Omar-404-BlackOps/AquaTrident/BOM.md

# AquaTrident – bill of materials

<!-- Generated by Half Life from project cmuvihf2q001z01pyso7ifghx. Edits here are overwritten on the next sync. -->
<!-- Generated: 2026-10-12T00:16:21.792Z -->

> [!NOTE]
> This parts list is mirrored from [Half Life](https://halflife.hackclub.com). Editing it here will not change the platform's copy, and the next sync overwrites this file.

| Week | Tier | Parts funding |
| --- | --- | --- |
| Week 1 | Tier 3 | $100.00 |

| Part | What it's for | Qty | Unit | Total | Vendor |
| --- | --- | --- | --- | --- | --- |
| [Arduino Uno Rev3](https://makerselectronics.com/product/arduino-uno-rev3/) | The main brain that controls the system. | 1 | $6.46 | $6.46 | [Makers Electronics](https://makerselectronics.com/product/arduino-uno-rev3/) |
| [20x4 LCD I2C Module](https://www.amazon.eg/-/en/ZHITING-Serial-Module-Arduino-Mega2560/dp/B0859YY2NZ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) | Displaying real-time readings for monitoring. | 1 | $4.25 | $4.25 | [Amazon.eg](https://www.amazon.eg/-/en/ZHITING-Serial-Module-Arduino-Mega2560/dp/B0859YY2NZ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) |
| [pH Sensor](https://makerselectronics.com/product/analog-ph-meter-sensor/) | An Analog sensor that measures the acidity/alkalinity and transmits the readings to the main processor. | 1 | $19.95 | $19.95 | [Makers Electronics](https://makerselectronics.com/product/analog-ph-meter-sensor/) |
| [Relay Module (1 Channel) Active Low Trigger 12V](https://makerselectronics.com/product/relay-module-1-channel-active-low-trigger-12v-hw-307/) | Control high voltage devices (pump, valve, and aerator), depending on the Arduino signals. | 3 | $0.76 | $2.28 | [Makers Electronics](https://makerselectronics.com/product/relay-module-1-channel-active-low-trigger-12v-hw-307/) |
| [Turbidity Sensor with Board Module](https://makerselectronics.com/product/tds-sensor-with-board-module-v1-0/) | An Analog sensor that measures water clarity by detecting suspended particles indicating water contamination levels. | 1 | $8.55 | $8.55 | [Makers Electronics](https://makerselectronics.com/product/tds-sensor-with-board-module-v1-0/) |
| [Analog TDS Sensor Module](https://makerselectronics.com/product/tds-sensor-with-board-module-v1-0/) | An Analog sensor that measures total dissolved solids (ppm) indicating water purity and salinity levels. | 1 | $8.55 | $8.55 | [Makers Electronics](https://makerselectronics.com/product/tds-sensor-with-board-module-v1-0/) |
| [12V DC Water Pump](https://makerselectronics.com/product/qr30e-ultra-quiet-brushless-dc-water-pump-12vdc-4-8w-300l-h-ip68/) | Pumps clean water into the system. | 1 | $4.75 | $4.75 | [Makers Electronics](https://makerselectronics.com/product/qr30e-ultra-quiet-brushless-dc-water-pump-12vdc-4-8w-300l-h-ip68/) |
| [Water Solenoid Valve 12V](https://makerselectronics.com/product/pressure-plastic-electric-water-sol/) | Drains contaminated water out of the system. | 1 | $3.32 | $3.32 | [Makers Electronics](https://makerselectronics.com/product/pressure-plastic-electric-water-sol/) |
| [Aerator Oxygen Pump](https://www.amazon.eg/-/en/VAYINATO-Electricals-Silent-Aerator-Oxygen/dp/B09GG6PHGM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) | Feeds the water with oxygen as well as stabilizing pH levels. | 1 | $9.31 | $9.31 | [Amazon.eg](https://www.amazon.eg/-/en/VAYINATO-Electricals-Silent-Aerator-Oxygen/dp/B09GG6PHGM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) |
| **Parts subtotal** | — | — | — | **$67.42** | — |
| **Tax & shipping** | — | — | — | **$0.00** | — |
| **Total** | — | — | — | **$67.42** | — |

$32.58 left of the tier's funding.
