Omar-404-BlackOps/AquaTrident/BOM.csv

Name | Purpose | Quantity | Total Cost (USD) | Link | Distributor
Clear Hose Tube Pipe | Enables transferring water into/out of the system. |  | 0.32 | https://makerselectronics.com/product/clear-hose-tube-pipe-6mmx4mm-1-meter/ | Makers Electronics
Arduino Uno Rev3 | The main brain that controls the system. | 1 | 28.48 | https://makerselectronics.com/product/arduino-uno-rev3-designed-and-assembled-in-italy/ | Makers Electronics
Solder-able Breadboard | Holds connections | 1 | 3.00 | https://makerselectronics.com/product/osepp-solder-able-breadboard/ | Makers Electronics
Jumper wires | Connecting components through breadboard. | 120 | 2.50 | https://www.amazon.eg/-/en/ELEGOO-Multicolored-Breadboard-Compatible-Projects/dp/B01EV70C78 | Amazon.eg
Sponge Filter Pads | Curing and filtering drained out water so it can be reused. | 1 | 20.87 | https://www.amazon.eg/-/en/Bukela-Aquarium-Reusable-Filters-Filtering/dp/B0FBRVPPZF | Amazon.eg
Activated Charcoal Carbon Pellets bag | Curing and filtering drained out water so it can be reused. | 1 | 20.89 | https://www.amazon.eg/-/en/gp/product/B07KPQ4RPY/ref=ewc_pr_img_1?smid=A29EIP580Q1AVP&psc=1 | Amazon.eg
Power Supply 12V 3A | Provides the system with adequate power (Current & Voltage). | 1 | 4.00 | https://makerselectronics.com/product/ab36w-12-power-supply-12v-3a/ | Makers Electronics
Relay Module 12V | Control high voltage devices (pump, valve, and aerator), depending on the Arduino signals. | 3 | 2.28 | https://makerselectronics.com/product/relay-module-1-channel-active-low-trigger-12v-hw-307/ | Makers Electronics
Aerator Oxygen Pump | Feeds the water with oxygen as well as stabilizing pH levels. | 1 | 9.31 | https://www.amazon.eg/-/en/VAYINATO-Electricals-Silent-Aerator-Oxygen/dp/B09GG6PHGM | Amazon.eg
Water Solenoid Valve 12V | Drains contaminated water out of the system. | 1 | 6.80 | https://www.amazon.eg/-/en/gp/product/B0DD7WXYCD/ref=ewc_pr_img_2?smid=A2DMKAT7ZKLGQN&psc=1 | Amazon.eg
12V DC Water Pump | Pumps clean water into the system. | 1 | 4.75 | https://makerselectronics.com/product/qr30e-ultra-quiet-brushless-dc-water-pump-12vdc-4-8w-300l-h-ip68/ | Makers Electronics
20x4 LCD I2C Module | Displaying real-time readings for monitoring. | 1 | 4.25 | https://www.amazon.eg/-/en/ZHITING-Serial-Module-Arduino-Mega2560/dp/B0859YY2NZ | Amazon.eg
Turbidity Sensor with Board Module | An Analog sensor that measures water clarity by detecting suspended particles indicating water contamination levels. | 1 | 8.55 | https://makerselectronics.com/product/tds-sensor-with-board-module-v1-0/ | Makers Electronics
Analog TDS Sensor Module | An Analog sensor that measures total dissolved solids (ppm) indicating water purity and salinity levels. | 1 | 8.55 | https://makerselectronics.com/product/tds-sensor-with-board-module-v1-0/ | Makers Electronics
pH Sensor | An Analog sensor that measures the acidity/alkalinity and transmits the readings to the main processor. | 1 | 19.95 | https://makerselectronics.com/product/analog-ph-meter-sensor/ | Makers Electronics
~10L Fish Tank | The main enclosure and body, and simulating an aquatic environment. | 1 | 75.00 | https://www.amazon.eg/-/en/gp/product/B091DXLBPS/ref=ewc_pr_img_1?smid=A17KADTUM4QTZ9&psc=1 | Amazon.eg
