Omar-404-BlackOps/AquaTrident/JOURNAL.md

# AquaTrident – devlog

<!-- Generated by Half Life from project cmuvihf2q001z01pyso7ifghx. Edits here are overwritten on the next sync. -->
<!-- Generated: 2026-10-12T00:46:14.590Z -->

> [!NOTE]
> This devlog is mirrored from [Half Life](https://halflife.hackclub.com). Editing it here will not change the platform's copy, and the next sync overwrites this file.

> AquaTrident, as its name suggests, is an aquaculture control/feedback system that monitors vital aquatic parameters, such as pH, Turbidity and TDS, designed for monitoring and regulating the environment conditions to be adequate for marine life specific types, in addition to providing real life data of the controlled system.

| Week | Tier | Hours logged | Entries |
| --- | --- | --- | --- |
| Week 1 | Tier 3 | 18.5h | 5 |

## Contents

1. [2026-10-11 – Project planning:](#2026-10-11-project-planning)
2. [2026-10-11 – Schematic Designing:](#2026-10-11-schematic-designing)
3. [2026-10-11 – I started working on editing the code for this session, and here is a mini part of the code:](#2026-10-11-i-started-working-on-editing-the-code-for-this-se)
4. [2026-10-11 – In this session I worked with a mate on the code, we faced a lot of errors and dysfunctions in the system, so we had a lot test trials to solve dysfunctions in order to make this system work out.](#2026-10-11-in-this-session-i-worked-with-a-mate-on-the-code-)
5. [2026-10-11 – pH Calibration](#2026-10-11-ph-calibration)

## Design

### 2026-10-11 – Project planning:

**1.5h**

Project planning:
Intro:
In this session I have planned the project, and for me I think that project planning can be divided into sections such as:

1.Main Plan

2.Materials Plan

3.Wiring Layout

4.Construction plan

so let's start with what I did for each part.

Main Plan:
Here is where I planned the above sections, and planned what I really want to do, so I decided to build an Aquaculure montoring system (Since I live in a coastal area), chose these 3 parameters: (pH, Turbidity and TDS), that I'll make a water recycling system .. that's only based on the desire of learning by making...

Then I moved to the next step so let us move to it as well.

Materials Plan:
Here is where I decided the materials, components, and electronoics that I'll work with, so I have done that by opening multiple local suppliers websites beside Amazon, as you can see here:




Then I started comparing items based on quality while having a wide eye on the price, so I had to ensure that I am picking a high quality item while maitaining the price is afforable, and I'll discuss why I chose every item in an upcoming journal.

Wiring Layout:
Here I planned all the wiring connections between each component and the other by designing a schematic diagram using "KiCad".

Construction plan:
Here is where I planned how I will construct and make every thing work out.

This isn't detailed since I am going to dive in details in the upcoming journals.
END OF THE JOURNAL...

### 2026-10-11 – Schematic Designing:

**6h**

Schematic Designing:
I worked on designed the schematic on KiCad, I faced a lot of obstacles since it was kind of my first time to design a schematic in my life, so I recommend watching tutorials before you start your own schematic. And here is how my first designing session ended:


Where I placed the main Arduino board, searched for the relay module and used the one in the image, placed 3 relay modules, and finally I placed 3 2x Pins to represent the actuators VCC & GND.

and then when I wanted to connect theses actuators to the relays, I got confused because of the relays, since their pins are labeled in number instead of actual labels (e.g. COM, IN, VCC, GND, NO, NC), so these connections need some research and understanding, which I am willing to do on the next working session.

Completing the Schematic:
I worked on solving the relay confusion and finally reached the solution and even understood the mechanism of how relays work, so here is how my schematic looked like after that designing session:


So here is how it went:

Relay modules’ A2 pins were connected to Arduino’s digital pins (D5, D6, D7) along with connecting A1 pins to Arduino’s 5V and connecting all NO pins to actuators positive pins enabling control.

All relay’s COM (common) pins were connected to the 12V power supply and finally a common ground was established across all the circuit ensuring a stable and safe circuit.

I finally Finished the Schematic (:
I worked on completing the schematic, and polishing it until it reached this pretty design:



Placed 2x pins to represent the sensors wires.
Sensors’ signal pins were connected to Arduino’s analog pins (A0, A1, A2) enabling real time monitoring, sensors VCC pins were connected to Arduino’s 5V providing safe operating voltage, and LCD were attached to the Arduino through I2C enabling data logging.

You might take a closer look here (:



and when I say polishing I mean solved the errors, organized all the wire connections to look that pretty, established the GND & Power flags and blocked (X) all the pins that I didn't need.

Although connections wasn't easy and costed me a lot of time learning and wiring them, it weren't the final obstcale in the design, just as any IDE has a checking tool, KiCad has the ERC tool, so when I used this tool, more than 10 errors popped up across the design, however I debugged them untill I reached this:





### 2026-10-11 – I started working on editing the code for this session, and here is a mini part of the code:

**3h**

I started working on editing the code for this session, and here is a mini part of the code:



I installed needed libraries, and defined some pins for the sensors and actuators, in addtion to defining the relays to normally closed (LOW as a standard), since we don't want the actuators to start working with start of the system, insteed we need the actuators to work when when we ask them to (as a reaction).



So for this part of code I needed to search the setpoint windows of every parameter I included (Acidity, Turbidty, Total dissolved Solids), and that means the maximum and minimum value that a parameter can reach before affecting the environment.



This is just a draft that I am going to edit later, I am just delaying the work since I have exams in that upcoming week, and if you reached this point I wanna say thank you (:

### 2026-10-11 – In this session I worked with a mate on the code, we faced a lot of errors and dysfunctions in the system, so we had a lot test trials to solve dysfunctions in order to make this system work out.

**2h**

In this session I worked with a mate on the code, we faced a lot of errors and dysfunctions in the system, so we had a lot test trials to solve dysfunctions in order to make this system work out.

We defined our variables for each parameter and defined the constants for the logical proccess to work. Then we deployed logical IF/When functions for each reaction and regulation. We also made the code for the LCD to work and print the values of the parameters values.





Here is an image of the code after we finished it.

### 2026-10-11 – pH Calibration

**6h**

pH Calibration
Aug 6, 2026, 1:07 AM
Omar Ezzat
We calibrated the sensors:
I searched and found out how to calibrate these sensors.

Two main calibration procedures were followed inside school chemistry lab:

A. Multipoint (3-point): this method was used to calibrate the pH sensor, where voltage was measured at 3 various standard buffer solutions (4,7,10).







So the reason I struggled with calibrating the pH sensor was that I needed 3 standard buffer solutions as I mentioned before, but my school only had the 4pH solution, and I had distilled water, meaning the alkli or the low acidity solution (10 pH) was missing, as a result I tried to calibrate only using them, I made progress but the sensor wasn't accurate as it should be, however solutions are expensive and I couldn't afford them as they are sold as whole containers.

Each sensor took nearly 2 days of work, however if the sensors are purchased from a trusted place, if solutions where fresh and you used the right calibration methods you won't struggle as I did.

and that is a video that shows us calibrating the pH sensor:

TDS & Turbidity Calibration
Aug 6, 2026, 1:12 AM
We calibrated TDS & Turbidity sensors:
Second Calibration method:
B. Zero and Span: this method was used to calibrate the TDS and Turbidity sensors, where voltage was measured at (0 ppm) and (0 NTU) respectively then at (1000 ppm) and (3000 NTU) respectively. Mapping output voltage to standard values, calibration curves were generated at Excel, driving equations that are used in code to convert raw voltage into real accurate measurements, as shown in this pic.:



a part of the TDS code.

we also developed with the help of AI a function to get the medium readings of a sensor so it is clearer and more accurate, as can be seen in this screenshot:



and this video shows a part of the process:

Finally, we uploaded the code on GitHub:
