Omar-404-BlackOps/AquaTrident/(commit log)

2026-06-05 Create BOM
2026-06-05 Rename AquaTrident-bom (1).csv to BOM.csv
    [BOM.csv]
2026-08-08 Adding BOM as a Table
2026-08-08 Fix formatting of BOM section in README
2026-10-11 Updating the pH sensor in BOM.csv
    Updated pH Sensor entry with new price and source.
2026-10-11 Fixing a format issue in BOM.csv
2026-10-11 Updating Turbidity Sensor in BOM.csv
    Updated BOM.csv to replace the Turbidity Sensor previous cost.
2026-10-11 Updating Relay module in BOM.csv
    Updated Relay Module entry with new supplier and price.
2026-10-12 Fixing formatting issues in BOM.csv
2026-10-12 Updating TDS Sensor Module in BOM.csv
    Updated the Analog TDS Sensor Module entry with a new price and source.
2026-10-12 Updating Pump on BOM.csv
